rtm3/ECE411/prototype.JPG

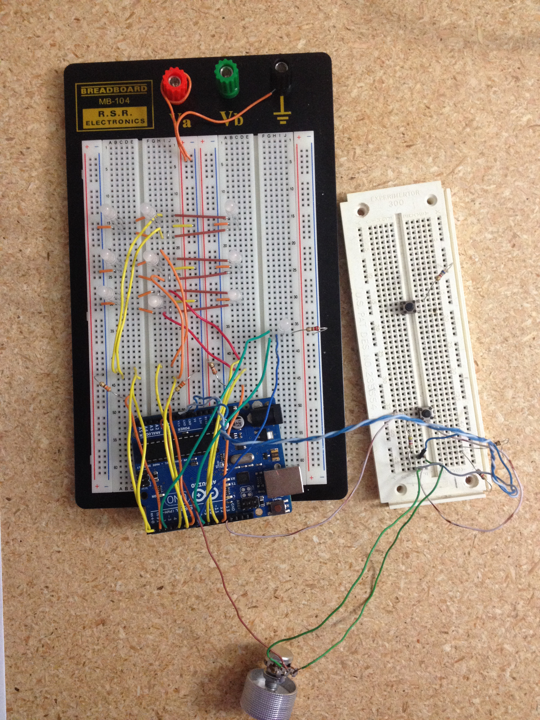
prototype.JPG
