rtm3/ECE411/README.md

ECE411 - T03
======

Group Design Project
