rtm3/ECE411/ECE411_BOM.xlsx

Number | List of materials | Quantity | Price | Provider | Total | Comments
1 | Atmel ATMEGA 328P | 1
2 | 16MHZ Resonance crystal | 1 |  |  |  | Thru-hole
3 | 330 ohm Resistor | 4
4 | 22microF Capacitor | 1 |  |  |  | Right capacity/quantity?
5 | 5mm Dual Color LEDs | 10 |  |  |  | red/green, thru-hole
6 | 10k Softpot potentiometer | 1
7 | 10k resistor | 1 |  |  |  | pull high for switch
8 | 1k resistor | 2 |  |  |  | one on the high pot leg and one on the selector leg
9 | 6mm pushbutton | 1
10 | slide switch | 1 |  |  |  | switch power on/off from batteries
11 | female headers for pot leads | 3 |  |  |  | Thru-hole
12 | male headers for programming | 6 |  |  |  | quantity?, thru-hole
13
14
15
16
17
18
19
20
21
