rtm3/ECE411/T03_Test_Cases.pdf

### ECE 411 Homework 6 Test Plan: Outline and Test Cases Dr. Mark Faust

November 24th, 2014
T03 – Tic Tac Toe
Robert “Tyler” McNichols
Wesley Murar
Edgard Musafiri
Sarmad “Sam” Butti

Revision: 2

Test Writer:
Test Case Name | Voltage Regulator Function Test | Type: | White Box ü Black Box
Description: | Verify conversion of 9V to 5V, where output to the system should be 5V.

Tester Information:
Name of Tester: | | Date:
Hardware Version: | 1.0 | Time:
Setup: | Connect function generator to voltage regulator independent of rest of the system, monitor output voltage via Multimeter.
Test: | Vin | Expected Result | Pass | Fail | N/A | Comments
1 | 9V | 5V
2 | 7V | 5V
3 | 5V | 5V – Vdrop
4 | 3V | 3V - Vdrop
Overall Test Result:

Test Writer:
Test Case Name | Integration test: Check Win Function. | Type: | White Box ü Black Box
Description: | Simulate all possible winning combinations, as well as a no-win situation. Verify the correct output LED response and assure matrix is reset.

Tester Information:
Name of Tester: | | Date:
Hardware Version: | 1.0 | Time :
Setup: | Make sure the system does not have any lit LEDS within the 3 x 3 LED matrix display.
Test: | Action | Expected Result | Pass | Fail | N/A | Comments
1 | Column 1 | Win function
2 | Column 2 | Win function
3 | Column 3 | Win function
4 | Row 1 | Win function
5 | Row 2 | Win function
6 | Row 3 | Win function
7 | Diagonal Right | Win function
8 | Diagonal Left | Win function
9 | Cat’s Game | Reset function
Overall Test Result

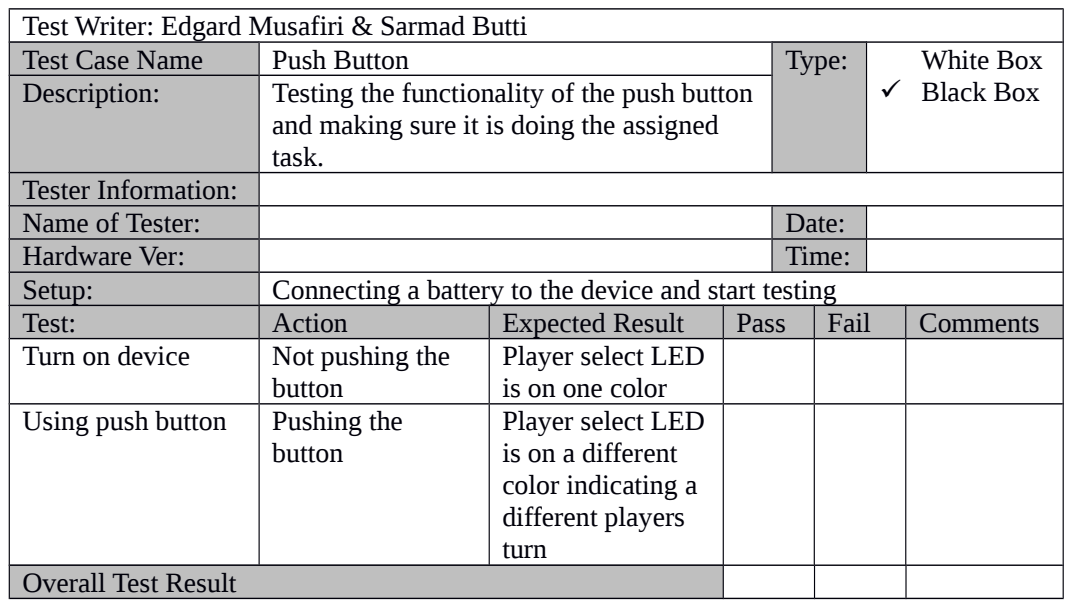
[picture p5: page 3]
Test Case Name; Push Button; Type:; White Box; Description:; Testing the functionality of the push button; ü Black Box; Tester Information:; Name of Tester:; Date:; Hardware Ver:; Time:; Setup:; Connecting a battery to the device and start testing; Test:; Action; Expected Result; Pass; Fail; Comments; Turn on device; Not pushing the; button; Using push button; Pushing the

Test Writer: Edgard Musafiri & Sarmad Butti

and making sure it is doing the assigned
task.

Player select LED
is on one color
is on a different
color indicating a
different players
turn

Overall Test Result

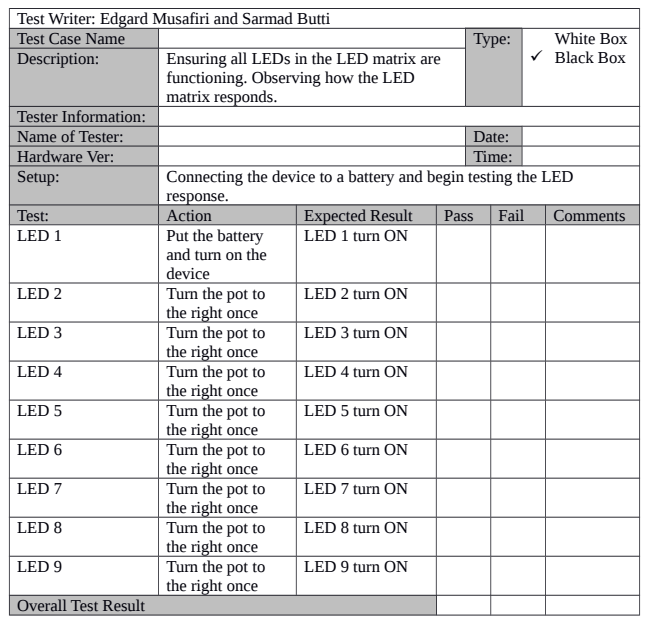
[picture p6: page 4]
Test Case Name; Type:; White Box; Description:; Ensuring all LEDs in the LED matrix are; ü Black Box; Tester Information:; Name of Tester:; Date:; Hardware Ver:; Time:; Setup:; Connecting the device to a battery and begin testing the LED; response.; Test:; Action; Expected Result; Pass; Fail; Comments; LED 1; Put the battery; LED 2; Turn the pot to; LED 3; LED 4; LED 5; LED 6; LED 7; LED 8; LED 9

Test Writer: Edgard Musafiri and Sarmad Butti

functioning. Observing how the LED
matrix responds.

LED 1 turn ON

and turn on the
device

LED 2 turn ON

the right once

LED 3 turn ON

LED 4 turn ON

LED 5 turn ON

LED 6 turn ON

LED 7 turn ON

LED 8 turn ON

LED 9 turn ON

Overall Test Result
