rtm3/ECE411/T03_Schedule_Gantt.pdf

ID | Task Name | | Sep 28, '14 | Oct 12, '14 | Oct 26, '14 | Nov 9, '14 | Nov 23, '14 | Dec 7, '14 | Dec 21, '14 | Jan 4, '15
W | S | T | M | F | T | S | W | S | T | M | F | T | S | W | S | T | M | F | T | S | W | S | T | M | F | T | S

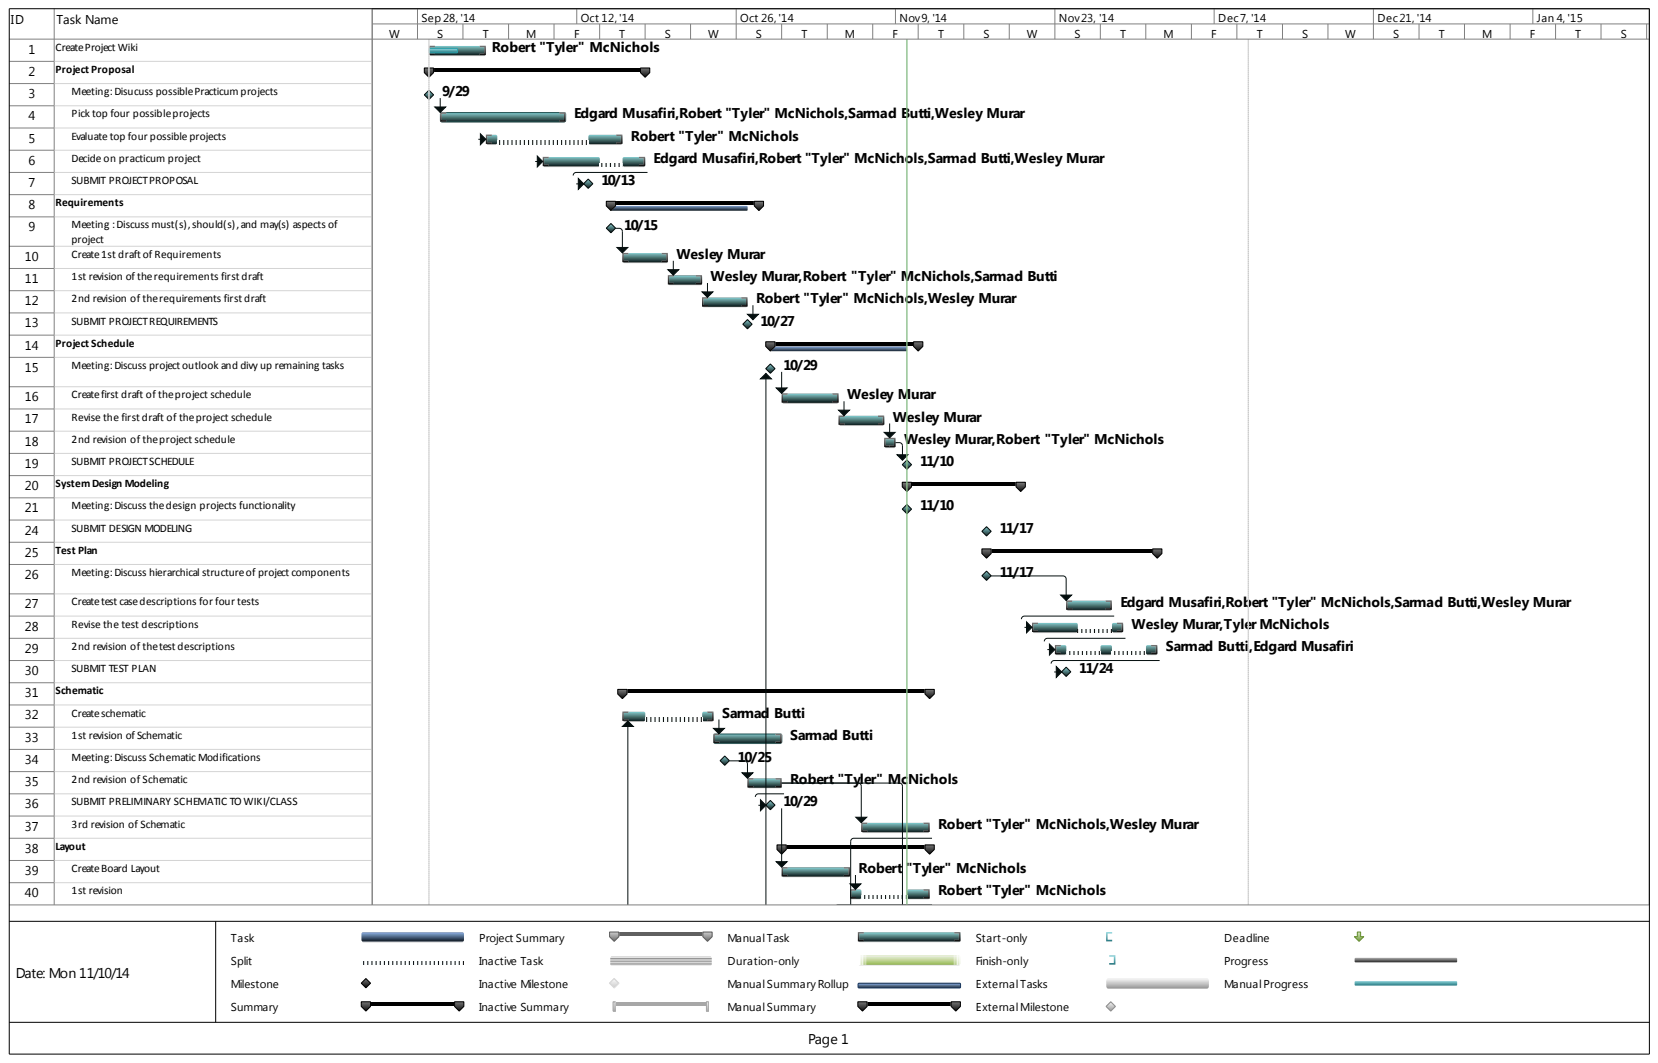
[picture p7: page 1]
Sarmad Butti Sarmad Butti; Robert "Tyler" McNichols 10/29; Manual Task; Duration-only; Manual Summary; Start-only; Finish-only

1 | Create Project Wiki | | | Robert "Tyler" McNichols | Edgard Musafiri,Robert "Tyler" McNichols,Sarmad Butti,Wesley Murar Robert "Tyler" McNichols Edgard Musafiri,Robert "Tyler" McNichols,Sarmad Butti,Wesley Murar | Robert "Tyler" McNichols,Wesley Murar

2 | Project Proposal

3 | Meeting: Disucuss possible Practicum projects

4 | Pick top four possible projects

5 | Evaluate top four possible projects

6 | Decide on practicum project

7 | SUBMIT PROJECT PROPOSAL

8 | Requirements

9 | Meeting : Discuss must(s), should(s), and may(s) aspects of project

Wesley Murar
Wesley Murar,Robert "Tyler" McNichols,Sarmad Butti

10 | Create 1st draft of Requirements

11 | 1st revision of the requirements first draft

12 | 2nd revision of the requirements first draft

13 | SUBMIT PROJECT REQUIREMENTS

14 | Project Schedule

15 | Meeting: Discuss project outlook and divy up remaining tasks

16 | Create first draft of the project schedule

Wesley Murar,Robert "Tyler" McNichols

17 | Revise the first draft of the project schedule

18 | 2nd revision of the project schedule

19 | SUBMIT PROJECT SCHEDULE

20 | System Design Modeling

21 | Meeting: Discuss the design projects functionality

24 | SUBMIT DESIGN MODELING

25 | Test Plan

26 | Meeting: Discuss hierarchical structure of project components

27 | Create test case descriptions for four tests

Edgard Musafiri,Robert "Tyler" McNichols,Sarmad Butti,Wesley Murar
Wesley Murar,Tyler McNichols
Sarmad Butti,Edgard Musafiri

28 | Revise the test descriptions

29 | 2nd revision of the test descriptions

30 | SUBMIT TEST PLAN

31 | Schematic

32 | Create schematic

33 | 1st revision of Schematic

34 | Meeting: Discuss Schematic Modifications

35 | 2nd revision of Schematic

36 | SUBMIT PRELIMINARY SCHEMATIC TO WIKI/CLASS

37 | 3rd revision of Schematic

Robert "Tyler" McNichols,Wesley Murar

38 | Layout

39 | Create Board Layout

Robert "Tyler" McNichols

40 | 1st revision

Date: Mon 11/10/14 | Task Split Milestone Summary | Project Summary Inactive Task Inactive Milestone Inactive Summary | Manual Summary Rollup | | External Tasks External Milestone | Deadline Progress Manual Progress

Page 1

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

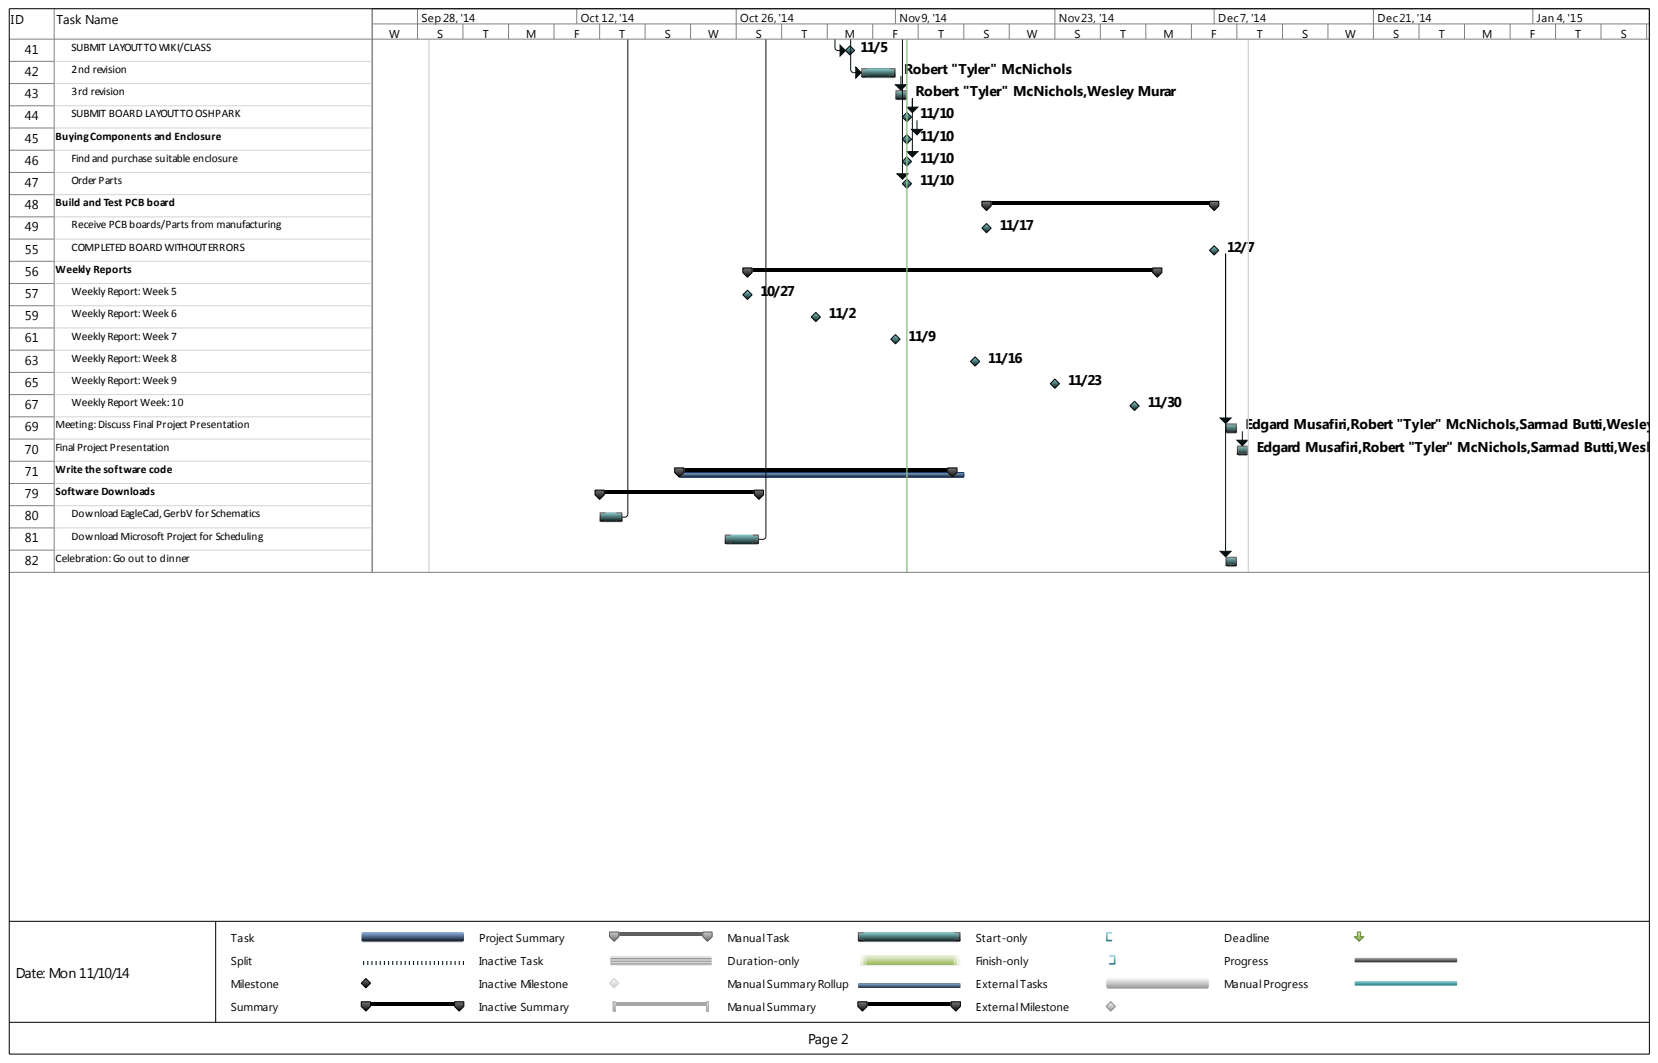
[picture p8: page 2]
Robert "Tyler" McNichols Robert "Tyler" McNichols,Wesley Murar 11/10 11/10 11/10 11/10; Duration-only; Manual Summary; Finish-only

41 | SUBMIT LAYOUT TO WIKI/CLASS

42 | 2nd revision

43 | 3rd revision

44 | SUBMIT BOARD LAYOUT TO OSHPARK

45 | Buying Components and Enclosure

46 | Find and purchase suitable enclosure

47 | Order Parts

48 | Build and Test PCB board

49 | Receive PCB boards/Parts from manufacturing

55 | COMPLETED BOARD WITHOUT ERRORS

56 | Weekly Reports

57 | Weekly Report: Week 5

59 | Weekly Report: Week 6

61 | Weekly Report: Week 7

63 | Weekly Report: Week 8

65 | Weekly Report: Week 9

67 | Weekly Report Week: 10

69 | Meeting: Discuss Final Project Presentation

Edgard Musafiri,Robert "Tyler" McNichols,Sarmad Butti,Wesley Murar

70 | Final Project Presentation

71 | Write the software code

79 | Software Downloads

80 | Download EagleCad, GerbV for Schematics

81 | Download Microsoft Project for Scheduling

82 | Celebration: Go out to dinner

Date: Mon 11/10/14 | Task Split Milestone Summary | Project Summary Inactive Task Inactive Milestone Inactive Summary | Manual Task Manual Summary Rollup | | Start-only External Tasks External Milestone | Deadline Progress Manual Progress

Page 2
