rtm3/ECE411/T03_Schematic.brd

## EAGLE design T03_Schematic.brd (2014-11-10)

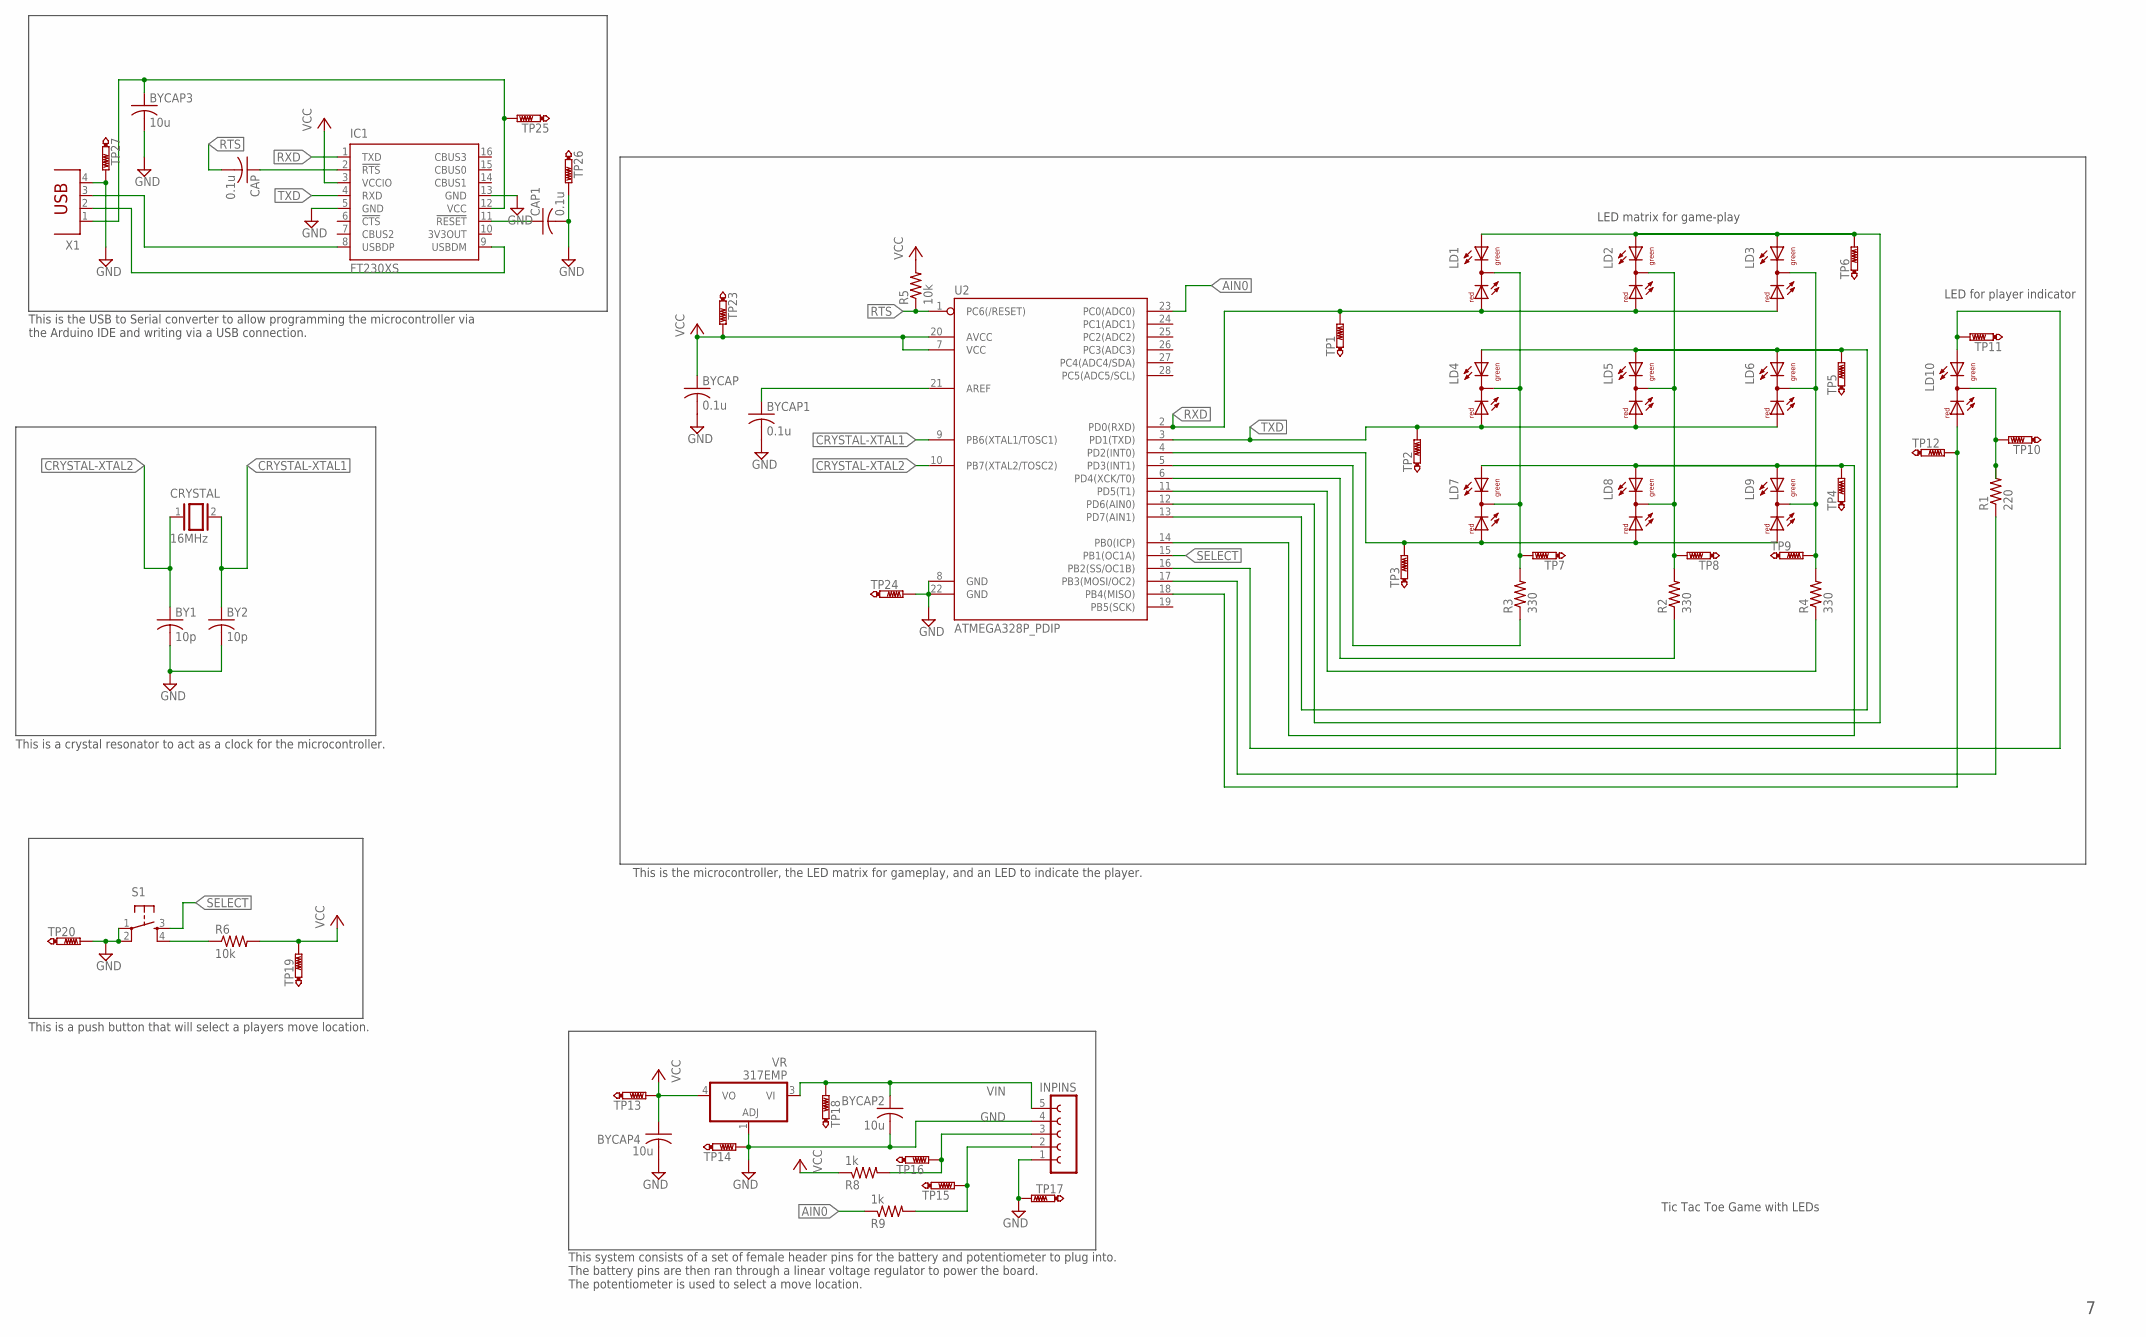
[picture p9: schematic T03_Schematic.sch]

Parts:
BY1, BY2: 10p; C0805
BYCAP, BYCAP1: 0.1u; C0805
BYCAP2, BYCAP3, BYCAP4: 10u; C0805
CAP, CAP1: 0.1u; C0805
CRYSTAL: 16MHz; QS
IC1: FT230XS; SSOP16
INPINS: FE05-1
LD1, LD2, LD3, LD4, LD5, LD6, LD7, LD8, LD9, LD10: DUOLED-RG-C; DUOLED-C-5MM
R1: 220; M0805
R2, R3, R4: 330; M0805
R5, R6: 10k; M0805
R8, R9: 1k; M0805
S1: DTS-6
TP1, TP2, TP3, TP4, TP5, TP6, TP7, TP8, TP9, TP10, TP11, TP12, TP13, TP14, TP15, TP16, TP17, TP18, TP19, TP20, TP23, TP24, TP25, TP26, TP27: PTR1B1,27; B1,27
U2: ATMEGA328P_PDIP; DIL28-3
VR: 317EMP; SOT223
X1: PN61729

Connections:
AIN0: R9.1, U2.23 (PC0(ADC0))
CATH1: R3.1, U2.5 (PD3(INT1))
CATH2: R2.1, U2.6 (PD4(XCK/T0))
CATH3: R4.1, U2.11 (PD5(T1))
CATH4: R1.1, U2.17 (PB3(MOSI/OC2))
CRYSTAL-XTAL1: BY2.1, CRYSTAL.2, U2.9 (PB6(XTAL1/TOSC1))
CRYSTAL-XTAL2: BY1.1, CRYSTAL.1, U2.10 (PB7(XTAL2/TOSC2))
D+: IC1.8 (USBDP), X1.3
D-: IC1.9 (USBDM), X1.2
GND: BY1.2, BY2.2, BYCAP.2, BYCAP1.2, BYCAP2.2, BYCAP3.2, BYCAP4.2, CAP1.2, IC1.5 (GND), IC1.13 (GND), INPINS.1, INPINS.4, S1.1, S1.2, TP14.TP, TP17.TP, TP20.TP, TP24.TP, TP26.TP, TP27.TP, U2.8 (GND), U2.22 (GND), VR.1 (ADJ), X1.4
GREN1: LD1.AX (AG), LD2.AX (AG), LD3.AX (AG), TP6.TP, U2.12 (PD6(AIN0))
GREN2: LD4.AX (AG), LD5.AX (AG), LD6.AX (AG), TP5.TP, U2.13 (PD7(AIN1))
GREN3: LD7.AX (AG), LD8.AX (AG), LD9.AX (AG), TP4.TP, U2.14 (PB0(ICP))
unnamed: LD1.C, LD4.C, LD7.C, R3.2, TP7.TP
unnamed: R6.1, S1.4
unnamed: LD2.C, LD5.C, LD8.C, R2.2, TP8.TP
unnamed: CAP.1, IC1.2 (!RTS)
unnamed: LD3.C, LD6.C, LD9.C, R4.2, TP9.TP
unnamed: CAP1.1, IC1.11 (!RESET)
unnamed: BYCAP1.1, U2.21 (AREF)
unnamed: LD10.C, R1.2, TP10.TP
PLAY1: LD10.AX (AG), TP11.TP, U2.16 (PB2(SS/OC1B))
PLAY2: LD10.AR, TP12.TP, U2.18 (PB4(MISO))
RED3: LD7.AR, LD8.AR, LD9.AR, TP3.TP, U2.4 (PD2(INT0))
RTS: CAP.2, R5.1, U2.1 (PC6(/RESET))
RXD: IC1.1 (TXD), LD1.AR, LD2.AR, LD3.AR, TP1.TP, U2.2 (PD0(RXD))
SELECT: S1.3, U2.15 (PB1(OC1A))
SELECTPIN: INPINS.2, R9.2, TP15.TP
TXD: IC1.4 (RXD), LD4.AR, LD5.AR, LD6.AR, TP2.TP, U2.3 (PD1(TXD))
USBVCC: BYCAP3.1, IC1.12 (VCC), TP25.TP, X1.1
V+POT: INPINS.3, R8.2, TP16.TP
VCC: BYCAP.1, BYCAP4.1, IC1.3 (VCCIO), R5.2, R6.2, R8.1, TP13.TP, TP19.TP, TP23.TP, U2.7 (VCC), U2.20 (AVCC), VR.4 (VO)
VIN: BYCAP2.1, INPINS.5, TP18.TP, VR.3 (VI)

Notes on the sheet:
LED matrix for game-play
LED for player indicator
Tic Tac Toe Game with LEDs
This system consists of a set of female header pins for the battery and potentiometer to plug into. The battery pins are then ran through a linear voltage regulator to power the board. The potentiometer is used to select a move location.
This is a push button that will select a players move location.
This is a crystal resonator to act as a clock for the microcontroller.
This is the USB to Serial converter to allow programming the microcontroller via the Arduino IDE and writing via a USB connection.
This is the microcontroller, the LED matrix for gameplay, and an LED to indicate the player.

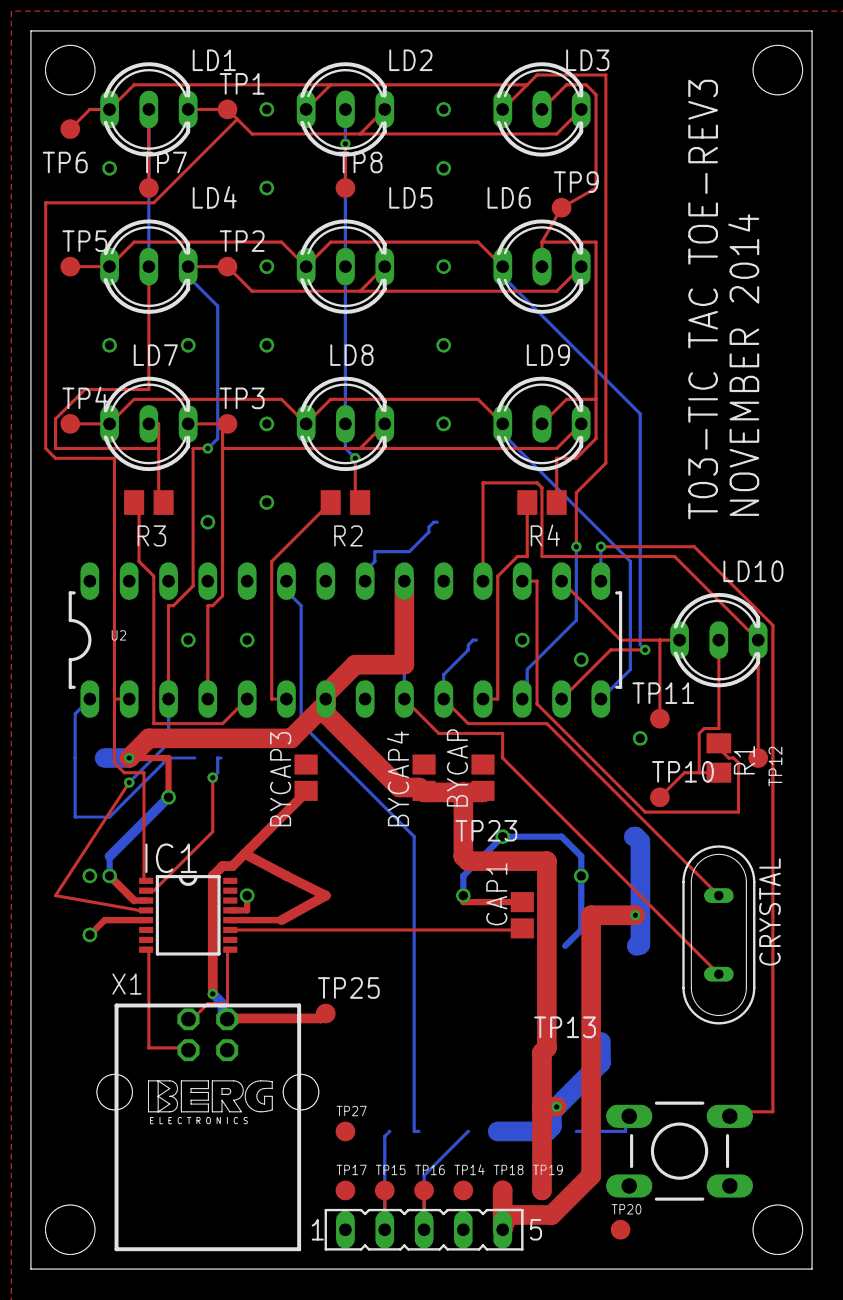
[picture p10: board T03_Schematic.brd from above]

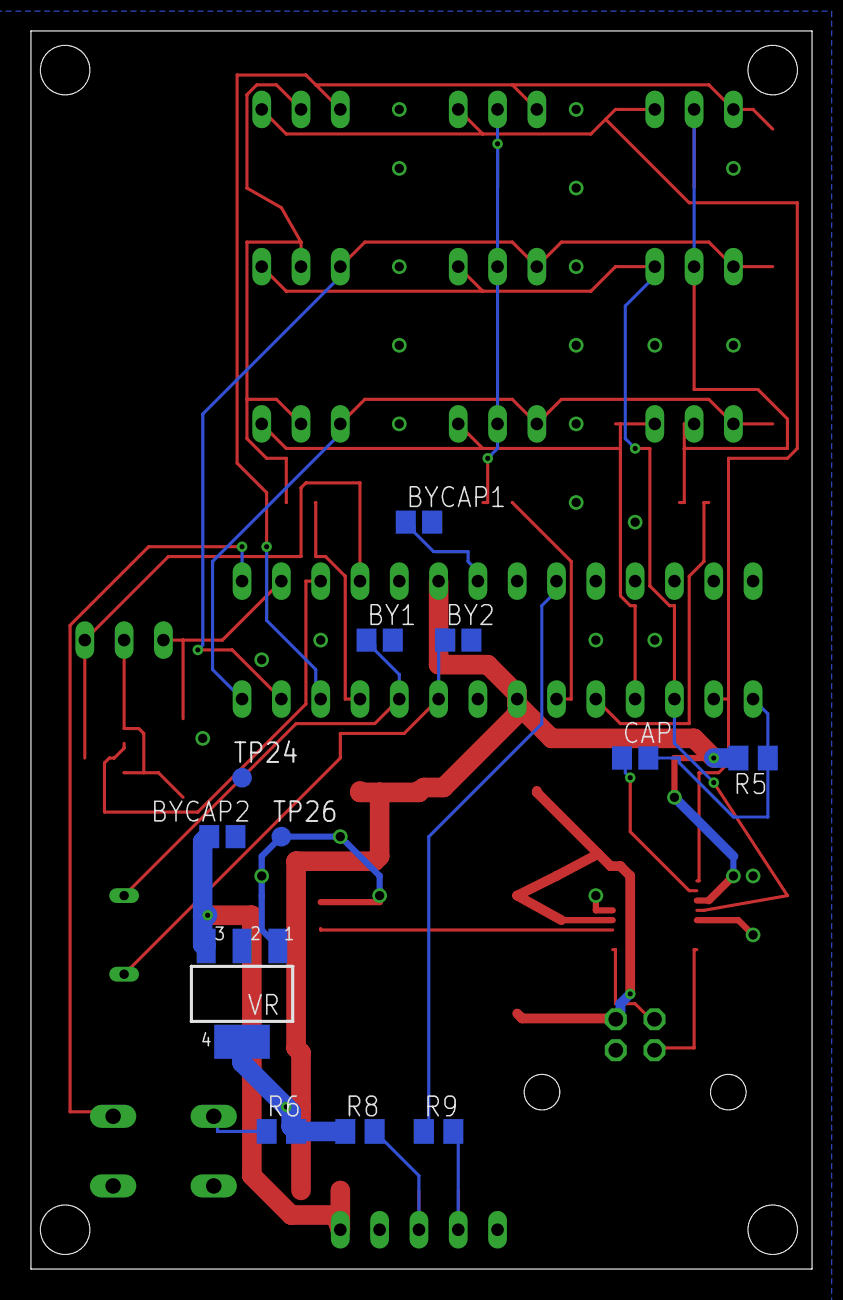
[picture p11: board T03_Schematic.brd from below]

Board: 2 copper layers, 50.5 x 80.0 mm, 59 parts (12 on the bottom side), 33 nets.
