rtm3/ECE411/(commit log)

2014-10-27 Initial Bill Of Materials to help with the schematic
    [ECE411_BOM.xlsx]
2014-10-28 bom for Sam to use while creating schematic picture of prototype
    [ECE411_BOM.xlsx]
2014-10-28 small changes in the spreadsheet formatting
    [ECE411_BOM.xlsx]
2014-10-29 this is a picture of the schematic so far
2014-10-29 Try opening this file on your eaglecad
    [Practicum_Schematic.sch]
2014-10-29 newer version ELC error free
    [Practicum_Schematic.sch]
2014-11-02 Renamed files to proper format
    [T03_Schematic.sch]
2014-11-04 rev 2 of schematic
    [T03_Schematic.sch]
2014-11-04 rev 3
    [T03_Schematic.sch]
2014-11-05 rev 4
    [T03_Schematic.sch]
2014-11-05 Added values to components
    [T03_Schematic.sch]
2014-11-05 Input pins and voltage regulator added. Rev 6
    [T03_Schematic.sch]
2014-11-05 Test points added to schematic, board created
    [T03_Schematic.brd, T03_Schematic.sch]
2014-11-09 Schematic has usb, new board
    [T03_Schematic.brd, T03_Schematic.sch]
2014-11-10 final layout and schematic
    [T03_Schematic.brd, T03_Schematic.sch]
